sbkirby/bird-feeder-monitor/getastronomy.py

# coding=utf-8

# Copyright (C) 2014  Stephen Kirby

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
# python-weather-api
# pywapi - https://code.google.com/p/python-weather-api/

# replace 'USTX1312' with your own location_id unless your interested in
# the sunrise and sunset in Sugar Land, TX.
# One spot to find your location_id to use with weather.com is
# https://weather.codes/ The location_id will be part of the url.

import pywapi

def piece(s, sep):
    stack = [s]
    for char in sep:
        pieces = []
        for substr in stack:
            pieces.extend(substr.split(char))
        stack = pieces
    return stack   
    
def minutes(h, m, ampm):
    t = int(h) * 60
    t = t + int(m)
    if ampm > 0:
       t = t + 720
    return str(t)

result = pywapi.get_weather_from_weather_com('USTX1312','imperial')
AM =  piece(result['forecasts'][0]['sunrise'],(':',' AM'))
sunrise = minutes(AM[0],AM[1],0)
PM = piece(result['forecasts'][0]['sunset'],(':',' PM'))
sunset = minutes(PM[0],PM[1],1)
print(sunrise + '^' + sunset)
